CUERT-dev/EcoJM/EcoJM/Doc/EcoJM_tref.md

# 1. Introduction

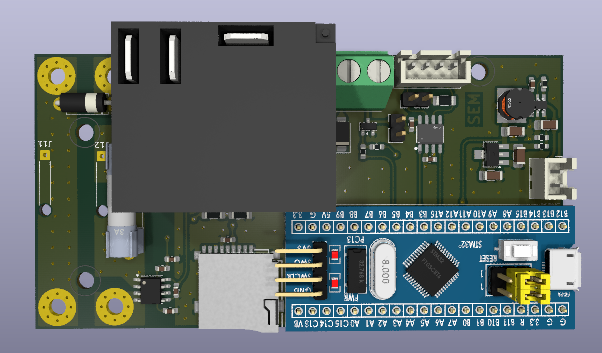
[picture p1: EcoJM/Doc/EcoJM.png]


## 1.1 Purpose
This document describes the architecture, design, implementation, and validation of the **EcoJM** vehicle energy measurement and safety control platform. It documents the hardware architecture used to realize the EcoJM implementation, including its modular functional partitioning, electrical interfaces, power distribution, automated switching key, measurement infrastructure, grounding strategy, PCB implementation, mechanical integration, and protection mechanisms.

The purpose of this document is to provide a technical reference for understanding how the EcoJM architectural principles are realized in the physical hardware, as well as to record the engineering decisions, constraints, and trade-offs that shaped the design. This document is intended to support continued development, maintenance, debugging, reproduction, and future evolution of the hardware.

---

## 1.2 EcoJM Scope
The EcoJM system implements an onboard Joulemeter intended to measure the total energy consumed by an Electric Vehicle (EV), while providing real-time hardware safety mechanisms. The system is composed of integrated hardware modules responsible for low-voltage signal conditioning, energy processing, data logging, and automated high-power load isolation.

The EcoJM implementation provides the hardware infrastructure required for high-precision energy measurement and automated protection, including:
* **Automated Switching & Isolation Key:** High-power relay for physical power-bus isolation.
* **Current & Voltage Measurement:** Analog front-end circuitry for real-time power sensing.
* **Control Infrastructure:** Microcontroller processing stage for calculation of energy metrics and safety logic execution.
* **CAN Communication:** Vehicle bus interface for streaming live telemetry and diagnostic data.
* **Onboard Data Storage:** MicroSD interface for continuous high-rate energy logging and event recording.
* **Fault & Protection Mechanisms:** Inline fuses, and transient suppression.

The scope of this document is limited to the EcoJM hardware implementation. Firmware algorithms, software state machines, and higher-level vehicle control strategies are discussed only where they directly affect hardware operation, switching logic, or electrical interfaces.

---

## 1.3 Design Objectives
The EcoJM hardware was developed to satisfy the following primary engineering objectives:

* **Real-time Vehicle Energy Tracking:** Maintain accurate, low-noise monitoring of instantaneous power and accumulation of total energy usage ($\text{Wh}/\text{kWh}$) drawn by the vehicle's the joulemeter under dynamic operating conditions.
* **Physical Disconnect:** Physical disconnect of loads through relay K1, when either JM supply fails, External NC Shutdown Switch opens, or internal logic command.

These objectives are treated as primary engineering requirements and trade-offs. Where requirements conflict, system safety, noise immunity, electrical performance, and circuit protection take strict precedence.

## 2. EcoJM System Architecture

## 2.1 System Overview
EcoJM is a Joule meter designed to measure the total energy consumed by an Electric Vehicle (EV). The system acquires electrical measurements, processes the measurement data through an mcu, and supports communication and data storage for energy monitoring and analysis.

## 2.2 Functional Block Diagram

The functional block diagram illustrates the main hardware modules of the EcoJM system, their interconnections, and the flow of power, measurement signals, and communication data.





## 2.3 Main Functional Domains
- **Processing and Control**: The mcu processes measurement signals, communicates with connected peripherals, and coordinates system-level operations.
- **Electrical Measurement**: The system acquires load measurements using a high-power voltage divider and an ACS712 20A Hall-effect current sensor. These signals are scaled down to safe analog voltages and provided to the MCU to calculate instantaneous power and total Joule consumption.
- **CAN Communication** Main field bus interface for the Joulemeter
- **Switching**: K1 is an SPDT relay acting as the main high-power switch for the connected load. The Relay coil is only activated when the JM is powered (12V supply healthy), External Shutdown switch Closed and internal fet closed (Fet can be bypassed through header).
- **Data Storage**: The HX TF PUSH is a microSD card socket connected to the MCU via a standard SPI interface. It provides external storage capabilities, likely for logging continuous energy consumption data.
- **Voltage Reference**: The TL431DBZ shunt regulator provides a highly stable 1% accurate 2.5V reference signal (VREF). This feeds directly into the MCU’s analog-to-digital converter (ADC) to ensure precise, calibrated readings from the voltage and current sensors.
- **Internal Power Supply**: The power supply section steps down a 12V external input to generate the required low-voltage supply rails. A switching regulator (MT2492) efficiently steps the 12V down to 5V, while an LDO linear regulator (AZ1117-3.3) drops the 5V to a clean 3.3V rail for the digital logic.

## 3. Hardware Architecture and Module Documentation

## 3.1 Microcontroller Unit
## 3.1.1 Purpose
The Microcontroller Unit (MCU) serves as the central control and data-processing element of the system. It receives measurement signals from the current and voltage sensing circuits through its analog-to-digital converter (ADC) inputs, controls the main power switching circuit, communicates with the vehicle network through the CAN interface, and manages data storage through the SPI interface.
The system uses an STM32F development board based on an STM32 microcontroller. The MCU operates from the regulated 3.3 V supply generated by the auxiliary power supply.

## 3.1.2 Architecture
The MCU is connected to the current measurement circuit through an analog input, where the conditioned output of the ACS712 current sensor is sampled by the ADC. A second ADC channel is used to acquire the scaled voltage measurement signal generated by the voltage measurement circuit.
A digital control signal is provided to the main relay switching circuit. This signal controls the relay driver and consequently determines whether the high-voltage path is connected to the external load.
For communication, the MCU uses its CAN transmit and receive signals to interface with the SIT65HVD230DR CAN transceiver. The MCU also communicates with the MicroSD card through the SPI peripheral for data logging.
The MCU is supplied from the 3.3 V regulated rail. The 5 V rail is used as an intermediate supply generated by the DC-DC converter and is subsequently regulated to 3.3V.
| Interface | MCU connection | Function |
| --- | --- | --- |
| ADC | Current_M | Current measurement |
| ADC | Voltage_M | Voltage measurement |
| GPIO | SSR0 / relay control | Main relay control |
| CAN TX/RX | CAN transceiver | Vehicle communication |
| SPI | MOSI, MISO, SCK, CS  | MicroSD data logging |
| VREF | TL431 reference | ADC reference |
| 3.3 V | Power input | MCU supply |

## 3.2 CAN Communication
## 3.2.1 Purpose
The CAN communication module provides an interface between the microcontroller and the vehicle CAN network. It allows the system to transmit measured electrical parameters and receive relevant vehicle information through the CAN bus.

## 3.2.2 Architecture

The CAN communication path is divided into two interfaces. The MCU-side interface consists of the CAN transmit (CAN_TX) and CAN receive (CAN_RX) signals. These signals are connected to the SIT65HVD230DR CAN transceiver.
The transceiver converts the logic-level CAN signals from the MCU into the differential CANH and CANL signals required by the physical CAN bus. The CANH and CANL lines are then connected to the external vehicle CAN network.
Protection components are placed at the external interface to reduce the risk of transient or fault conditions propagating into the communication circuitry.

## 3.3 Main Load Switch
## 3.3.1 Purpose
The main power switch controls the connection between the vehicle high-voltage power source and the external load. The switching function is implemented using a relay controlled by the microcontroller through an appropriate driver circuit, with secondary provisions for hardware-level manual override and transient voltage protection.

## 3.3.2 Architecture

EV HV Power → K1 Relay SPDT → Switched HV Output - External Load

STM32F MCU → Relay Control → MOSFET → K1 Relay

When the MCU determines that the main power path should be enabled, it generates the relay-control signal. The MOSFET driver circuit energizes the relay coil, causing K1 to change state. The HV path is then connected to the switched output. When the control signal is removed, the relay returns to its default open state. A flyback diode is connected across the relay coil to suppress the voltage transient generated when the relay coil is de-energized, which protects the switching transistor from excessive voltage stress.

Manual Bypass Interface: Connectors J1 and J10 are wired directly in parallel with the control MOSFET. This allows external hardware, such as a physical toggle switch or an emergency stop button, to ground the relay coil and engage the main power path completely independent of MCU intervention.   
Transient Voltage Protection: A Transient Voltage Suppression (TVS) diode (D1) is placed across the switched high-voltage output lines (VDCH+_OUT and VDCH-). If a sudden transient voltage spike or surge occurs on the power lines, this diode instantly shunts the excess energy, protecting the external load and preventing damage to the system. 

## 3.4 Current Measurement — Joule Meter
## 3.4.1 Purpose
The current measurement module measures the current flowing through the monitored electrical path. The measured current is converted into an analogue voltage by the ACS712 Hall-effect current sensor and sampled by the STM32 ADC. The measured current is subsequently used together with the measured voltage to calculate electrical power and accumulated energy.

## 3.4.2 ACS712 operation
The ACS712 provides electrical isolation between the high-current conductor and the low-voltage measurement circuitry using Hall-effect sensing. The output of the sensor is an analog voltage whose value varies according to the current flowing through the monitored conductor.

## 3.4.3 ADC interface
The 5V analog output of the ACS712 is stepped down through a resistor voltage divider (R6 and R7) to safely scale the signal below 3.3V, creating the Current_M signal that is sampled by the STM32 ADC.

## 3.5 Voltage Measurement

## 3.5.1 Purpose
The primary purpose of the voltage measurement module is to monitor line voltages across the active power path. A high-side resistive voltage divider attenuates input signals to a safe potential range appropriate for direct sampling by the internal Analog-to-Digital Converter (ADC) of the STM32 microcontroller. The digitized voltage measurement is combined with concurrent current readings to compute instantaneous electrical power and accumulated energy consumption.

## 3.5.2 Operating Limits
The resistor network composed of $R_{9}$ ($47\text{ k}\Omega$) and $R_{10}$ ($2.7\text{ k}\Omega$) forms a voltage divider with a scaling ratio of $18.407 : 1$. Assuming a maximum allowed ADC reference voltage of $3.3\text{ V}$, the theoretical upper bound of the input voltage measurement range is:

$$V_{\text{MAX}} = 3.3\text{ V} \times 18.407 \approx 60.74\text{ V}$$

## 3.5.3 ADC Interface
The scaled output signal ($V_{\text{OUT}} \le 3.3\text{ V}$) is routed directly to an analog input pin on the STM32 microcontroller (`Voltage_M`), enabling real-time voltage tracking and energy integration algorithms.

---

## 3.6 Voltage Reference

## 3.6.1 Purpose
The voltage reference subsystem delivers a precise and highly stable $2.5\text{ V}$ reference baseline (`VREF`) to the analog conversion subsystem, ensuring high accuracy, minimal thermal drift, and reproducible sensor measurements.

## 3.6.2 Circuit Architecture & Calculation
The subsystem employs a TL431 shunt regulator IC (`U2`). To ensure proper regulation, the chip requires a cathode operating current above its minimum knee current ($I_{\text{K,MIN}} \approx 1\text{ mA}$).

Resistor $R_{19}$ ($470\ \Omega$) serves as the primary current-limiting element connected to the $+3.3\text{ V}$ rail. The operating bias current is calculated as:

$$I_{\text{bias}} = \frac{V_{\text{IN}} - V_{\text{REF}}}{R_{19}} = \frac{3.3\text{ V} - 2.5\text{ V}}{470\ \Omega} = \frac{0.8\text{ V}}{470\ \Omega} \approx 1.7\text{ mA}$$

Because $1.7\text{ mA} > 1.0\text{ mA}$, the regulator remains stably biased within its optimal operating region while generating a precise output voltage ($V_{\text{REF}} = 2.495\text{ V} \approx 2.5\text{ V}$) for the microcontroller's reference input.

---

## 3.7 MicroSD Card Interface

## 3.7.1 Purpose & Objectives
The MicroSD card interface provides persistent, non-volatile mass storage for the system. It allows the host microcontroller to record high-rate measurement telemetry over extended operational periods.

* **Non-Volatile Data Logging:** Continuously stores high-frequency sensor readings (voltage, current, power, and calculated energy in Joules) to preserve log data across system power cycles.
* **System Configuration & Firmware Updates:** Reads configuration parameters and enables field firmware updates without requiring direct re-flashing of the microcontroller unit.
* **SPI Bus Communication:** Configured in 1-bit Serial Peripheral Interface (SPI) mode to reduce microcontroller GPIO pin usage to just 4 control lines (`CS`, `MOSI`, `MISO`, and `SCK`).

## 3.7.2 Pinout Mapping

| Pin # | SD Card Label | SPI Mode Signal | Signal Direction | Description |
| :--- | :--- | :--- | :--- | :--- |
| 1, 8 | DAT2, DAT1 | *Not Connected* | — | Unused in 1-bit SPI communications mode. |
| 2 | CD / DAT3 | `SD_CS` | MCU $\rightarrow$ SD | **Chip Select (CS):** Active-low SPI target enable signal. |
| 3 | CMD | `SPI_MOSI` | MCU $\rightarrow$ SD | **Master Out Slave In:** Serial command and data line from MCU. |
| 4 | VDD | $+3.3\text{V}$ | Power | $+3.3\text{ V}$ main supply line. |
| 5 | CLK | `SPI_SCK` | MCU $\rightarrow$ SD | **Serial Clock:** Synchronous clock generated by host MCU. |
| 6 | VSS | `GND` | Power | System Ground reference point. |
| 7 | DAT0 | `SPI_MISO` | SD $\rightarrow$ MCU | **Master In Slave Out:** Serial data response line from SD card. |
| 10–13 | SHELL | `GND` | Shield | Metallic connector housing grounded for EMI and strain relief. |

---

# 3.8 Component Datasheets

| Component | Part Number | Datasheet Link |
| :--- | :--- | :--- |
| DC-DC Buck Converter | MT2492 | [Datasheet](https://lcsc.com/product-detail/DC-DC-Converters_MT2492_C89358.html) |
| Linear LDO Regulator | AZ1117-3.3 | [Datasheet](https://www.diodes.com/assets/Datasheets/AZ1117.pdf) |
| CAN Transceiver | SIT65HVD230DR | [Datasheet](https://lcsc.com/product-detail/New-Arrivals_SIT-SIT65HVD230DR_C496619.html) |
| MicroSD Connector | HX TF PUSH | [Datasheet](https://www.lcsc.com/datasheet/C5184837.pdf) |
| Voltage Reference | TL431DBZ | [Datasheet](http://www.ti.com/lit/ds/symlink/tl431.pdf) |
| Current Sensor | ACS712xLCTR-30A | [Datasheet](http://www.allegromicro.com/~/media/Files/Datasheets/ACS712-Datasheet.ashx?la=en) |
| N-Channel MOSFET | AO3400A | [Datasheet](https://www.aosmd.com/sites/default/files/res/datasheets/AO3400A.pdf) |

## UNDER DEVELOPMENT

## 4. Instrumentation and Measurement

## 4.1 Instrumentation Objectives
## 4.2 Required Equipment
## 4.3 Test Points and Measurement Nodes
## 4.4 Initial Power-Up Procedure
## 4.5 Power Rail Measurements
## 4.6 Current Measurement Testing
## 4.7 Voltage Measurement Testing
## 4.8 CAN Communication Testing
## 4.9 MicroSD Interface Testing
## 4.10 Main Switch Testing

## 5. Calibration

## 5.1 Calibration Objectives
## 5.2 Calibration Requirements
## 5.3 Current Sensor Calibration
## 5.4 Voltage Measurement Calibration
## 5.5 Calibration Procedure
## 5.6 Calibration Data
## 5.7 Calibration Error and Uncertainty
## 5.8 Calibration Results

## 6. PCB Implementation and Mechanical Integration

## 6.1 PCB Overview
The EcoJM PCB integrates the main system components, including the STM32F_dev MCU, CAN communication interface, microSD storage, voltage and current measurement circuits, relay switching, and auxiliary power supply. The design combines measurement, processing, communication, and power management within a single board.

PCB Design Link:  https://github.com/CUERT-dev/EcoJM/blob/main/EcoJM/EcoJM.kicad_pcb 

Schematic Design Link: https://github.com/CUERT-dev/EcoJM/blob/main/EcoJM/EcoJM.kicad_sch

## 6.2 Component Placement
## 6.3 Routing and Layout Considerations
## 6.4 Power and Signal Separation
## 6.5 Connectors and Accessibility
## 6.6 Mounting Holes and Mechanical Features
## 6.7 3D Model Generation

## 7. Validation and Bring-Up

## 7.1 Initial Bring-Up
## 7.2 Low-Voltage Testing
## 7.3 Power Supply Validation
## 7.4 MCU and Communication Validation
## 7.5 ADC and Measurement Validation
## 7.6 Main Switching Validation
## 7.7 MicroSD Validation
## 7.8 Integrated Hardware Testing

## 8. Known Issues and Limitations

## 8.1 Known Hardware Issues
## 8.2 Measurement Limitations
## 8.3 Calibration Limitations
## 8.4 Documentation Gaps
## 8.5 Mechanical and PCB Limitations

## 9. Future Development

## 9.1 Hardware Improvements
## 9.2 Measurement Improvements
## 9.3 Protection Improvements
## 9.4 Communication and Data Logging Improvements
## 9.5 Mechanical Improvements

## 10. Revision History
