CUERT-dev/EcoJM/EcoJM/EcoJM.kicad_pcb

## KiCad design EcoJM/EcoJM.kicad_pcb (2026-09-05)

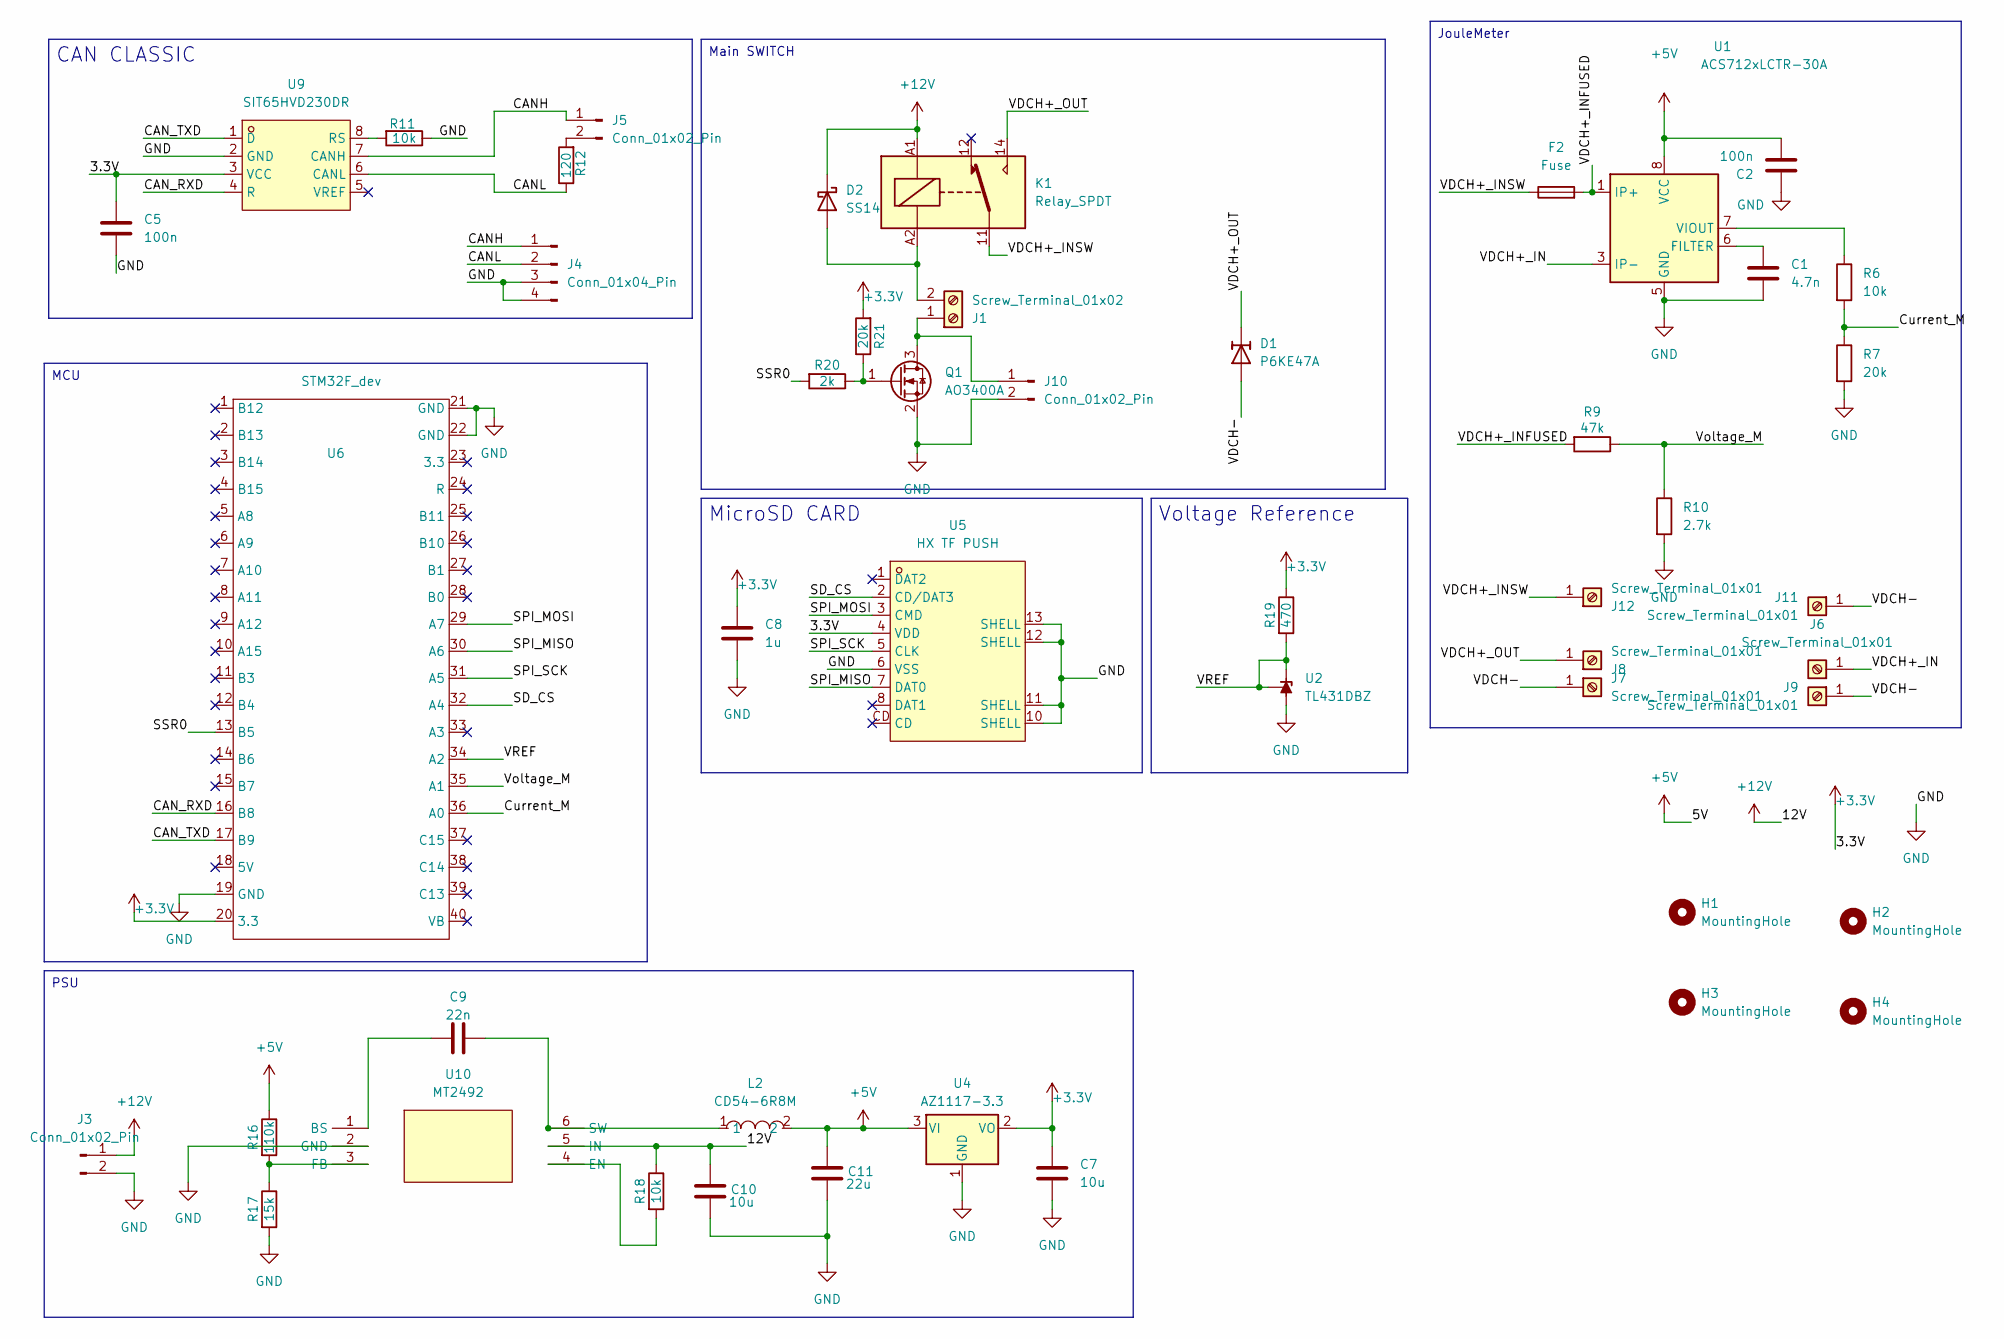
[picture p3: schematic EcoJM.kicad_sch]

Parts:
C1: 4.7n; C_0603_1608Metric_Pad1.08x0.95mm_HandSolder
C2, C5: 100n; C_0603_1608Metric_Pad1.08x0.95mm_HandSolder
C7, C10: 10u; C_1206_3216Metric_Pad1.33x1.80mm_HandSolder
C8: 1u; C_0603_1608Metric_Pad1.08x0.95mm_HandSolder
C9: 22n; C_0603_1608Metric_Pad1.08x0.95mm_HandSolder
C11: 22u; C_1206_3216Metric_Pad1.33x1.80mm_HandSolder
D1: P6KE47A; D_DO-15_P10.16mm_Horizontal
D2: SS14; D_SMA
F2: Fuse; Fuseholder_Clip-5x20mm_Littelfuse_520_Inline_P20.50x5.80mm_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
H1, H2, H3, H4: MountingHole; MountingHole_3.2mm_M3_DIN965
J1: Screw_Terminal_01x02; TerminalBlock_Phoenix_MKDS-1,5-2_1x02_P5.00mm_Horizontal
J3: Conn_01x02_Pin; JST_XH_B2B-XH-A_1x02_P2.50mm_Vertical
J4: Conn_01x04_Pin; JST_XH_B4B-XH-A_1x04_P2.50mm_Vertical
J5, J10: Conn_01x02_Pin; PinHeader_1x02_P2.54mm_Vertical
J6, J7, J8, J9: Screw_Terminal_01x01; M3_PCONN_1x01
J11, J12: Screw_Terminal_01x01; SolderWire-0.25sqmm_1x01_D0.65mm_OD1.7mm_Relief
K1: Relay_SPDT; T91 30A
L2: CD54-6R8M; IND-SMD_L5.8-W5.2_CD54; MPN CD54-6R8M; LCSC Part C7588992
Q1: AO3400A; SOT-23
R6, R11: 10k; C_0603_1608Metric_Pad1.08x0.95mm_HandSolder
R7: 20k; C_0603_1608Metric_Pad1.08x0.95mm_HandSolder
R9: 47k; R_1206_3216Metric_Pad1.30x1.75mm_HandSolder
R10: 2.7k; R_1206_3216Metric_Pad1.30x1.75mm_HandSolder
R12: 120; R_1206_3216Metric_Pad1.30x1.75mm_HandSolder
R16: 110k; R_0603_1608Metric_Pad0.98x0.95mm_HandSolder
R17: 15k; R_0603_1608Metric_Pad0.98x0.95mm_HandSolder
R18: 10k; R_0603_1608Metric_Pad0.98x0.95mm_HandSolder
R19: 470; R_0603_1608Metric_Pad0.98x0.95mm_HandSolder
R20: 2k; R_0603_1608Metric_Pad0.98x0.95mm_HandSolder
R21: 20k; R_0603_1608Metric_Pad0.98x0.95mm_HandSolder
U1: ACS712xLCTR-30A; SOIC-8_3.9x4.9mm_P1.27mm
U2: TL431DBZ; SOT-23
U4: AZ1117-3.3; SOT-89-3_Handsoldering
U5: HX TF PUSH; TF-SMD_TF-PUSH; MPN HX TF PUSH; LCSC Part C5184837
U6: STM32F_dev; STM32F_devboard
U9: SIT65HVD230DR; SOP-8_L4.9-W3.9-P1.27-LS6.0-BL; MPN SIT65HVD230DR; LCSC Part C496619
U10: MT2492; SOT-23-6_L2.9-W1.6-P0.95-LS2.8-BL_3; MPN MT2492; LCSC Part C89358

Connections:
+3.3V: C5.1, C7.1, C8.1, R19.1, R21.2, U4.2 (VO), U5.4 (VDD), U6.20 (3.3), U9.3 (VCC)
+5V: C2.2, C11.1, L2.2, R16.1, U1.8 (VCC), U4.3 (VI); also elsewhere on the board
+12V: C10.1, D2.1 (K), J3.1, K1.A1, R18.1, U10.5 (IN)
/CANH: J4.1, J5.1, U9.7 (CANH)
/CANL: J4.2, R12.1, U9.6 (CANL)
/CAN_RXD: U6.16 (B8), U9.4 (R)
/CAN_TXD: U6.17 (B9), U9.1 (D)
/Current_M: R6.2, R7.1, U6.36 (A0)
/SD_CS: U5.2 (CD/DAT3), U6.32 (A4)
/SPI_MISO: U5.7 (DAT0), U6.30 (A6)
/SPI_MOSI: U5.3 (CMD), U6.29 (A7)
/SPI_SCK: U5.5 (CLK), U6.31 (A5)
/SSR0: R20.2, U6.13 (B5)
/VDCH+_IN: J6.1 (Pin_1_1), U1.3 (IP-), U1.4 (IP-)
/VDCH+_INFUSED: F2.2, R9.2, U1.1 (IP+), U1.2 (IP+)
/VDCH+_INSW: F2.1, J12.1 (Pin_1_1), K1.11
/VDCH+_OUT: D1.1 (K), J8.1 (Pin_1_1), K1.14
/VDCH-: D1.2 (A), J7.1 (Pin_1_1), J9.1 (Pin_1_1), J11.1 (Pin_1_1)
/VREF: R19.2, U2.1 (K), U2.2 (REF), U6.34 (A2)
/Voltage_M: R9.1, R10.1, U6.35 (A1)
GND: C1.2, C2.1, C5.2, C7.2, C8.2, C10.2, C11.2, J3.2, J4.3, J4.4, J10.2, Q1.2 (S), R7.2, R10.2, R11.1, R17.2, U1.5 (GND), U2.3 (A), U4.1 (GND), U5.6 (VSS), U5.10 (SHELL), U5.11 (SHELL), U5.12 (SHELL), U5.13 (SHELL), U6.19 (GND), U6.21 (GND), U6.22 (GND), U9.2 (GND), U10.2 (GND); also elsewhere on the board
unnamed: D2.2 (A), J1.2, K1.A2
unnamed: J1.1, J10.1, Q1.3 (D)
unnamed: J5.2, R12.2
unnamed: Q1.1 (G), R20.1, R21.1
unnamed: C1.1, U1.6 (FILTER)
unnamed: R6.1, U1.7 (VIOUT)
unnamed: R11.2, U9.8 (RS)
unnamed: C9.2, U10.1 (BS)
unnamed: R18.2, U10.4 (EN)
unnamed: R16.2, R17.1, U10.3 (FB)
unnamed: C9.1, L2.1, U10.6 (SW)

Notes on the sheet:
MicroSD CARD
CAN CLASSIC
Main SWITCH
MCU
JouleMeter
PSU
Voltage Reference

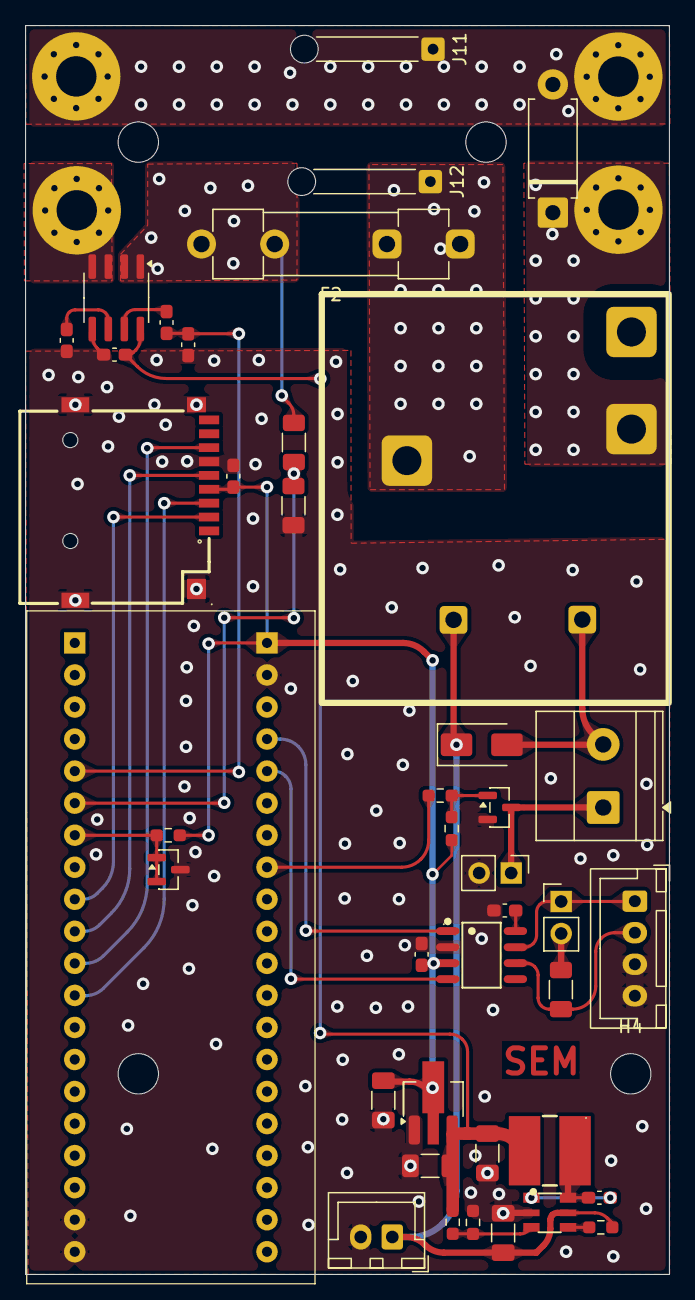
[picture p4: board EcoJM.kicad_pcb from above]

Board: 2 copper layers, 51.0 x 99.0 mm, 49 parts (0 on the bottom side), 32 nets.

Other parts of the board:
C9#2: 22u; C_1206_3216Metric_Pad1.33x1.80mm_HandSolder

Their connections:
+5V: C9#2.1; also elsewhere on the board
GND: C9#2.2; also elsewhere on the board
