CUERT-dev/EcoJM/(commit log)

2026-02-12 bahr updoad
    [EcoJM.kicad_sch]
2026-02-14 sry forgot to save schematic xD
    sry forgot to save schematic xD
    [EcoJM.kicad_sch]
2026-02-14 Schematic = 100% , Footprints=100%
    [3524529e422e449cba22e59366074993.obj, 3524529e422e449cba22e59366074993.step, C3025164.json, C5189958.json, C842818.json, EcoJM.kicad_pcb, EcoJM.kicad_sch, d6cda2de884741da97ac8a4b11e9c725.obj]
2026-02-14 Updates
    R variable added to op amp
    Buck converter V division Resistors values added
    [EcoJM.kicad_sch]
2026-02-15 Schematic REV by OMAR_MAGDY , REV0 Layout 80%
    [EcoJM.kicad_pcb, EcoJM.kicad_sch]
2026-02-18 Routing Finished
    bhbk ya Omar ya Magdy
    [EcoJM.kicad_pcb]
2026-02-18 nseet a3ml save
    sorry
    [EcoJM.kicad_pcb]
2026-09-03 diff amp removed + potentiometer removed +SD card schematic done
    diff amp removed + potentiometer removed +SD card schematic done
    [EcoJM.kicad_sch]
2026-09-05 RevA finito, revision, reroute, refurbish
    [3524529e422e449cba22e59366074993.obj, 3524529e422e449cba22e59366074993.step, C3025164.json, C5189958.json, C842818.json, EcoJM.kicad_pcb, EcoJM.kicad_sch, d6cda2de884741da97ac8a4b11e9c725.obj]
2026-09-05 Quick fix, minor modifications
    [EcoJM.kicad_pcb, EcoJM.kicad_sch]
2026-09-26 Add EcoJM.md file covering the introduction and overview, EcoJM System Architecture, Hardware Architecture and Module Documentation (#7)
    * Create EcoJM.md
    * Add trial text to EcoJM.md
    * Expand EcoJM.md with introduction and design objectives
    Added detailed sections on the introduction, scope, and design objectives of the EcoJM hardware implementation.
    * Enhance EcoJM.md with introduction and purpose details
    Added an introductory image and expanded the purpose section to clarify the document's intent and scope.
    * Expand EcoJM documentation with system architecture details
    Added detailed sections on system architecture, functional domains, and power flow for the EcoJM Joule meter.
    * Up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
